dreiiuu/CPE027-soil-dsp/docs/handoff/Smart_Irrigation_DSP_Software_Handoff.md

# CONTEXT AND IMPLEMENTATION PROMPT FOR DSP / SOFTWARE DEVELOPMENT

I am building an **ESP32-S3 N16R8-based soil moisture monitoring and automatic irrigation prototype**. Please use the details in this handoff as the project baseline, and use the attached **`Smart_Irrigation_ESP32S3_Final.ino`** as the source of truth for firmware behavior and telemetry. Do not assume hardware or features have been proven unless explicitly marked as verified.

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

## 5. Firmware behavior (attached .ino v1)
- **Boot:** The relay is driven to its configured de-energized electrical state as soon as possible; automatic watering defaults to OFF. External LED is tested for 2 seconds at startup. The TFT is initialized and keeps its static title/labels. Automatic pump commands are blocked until an explicit code constant `PUMP_HARDWARE_VERIFIED` is changed to `true` after physical correction and supervised tests.
- **Sampling:** Every **1 second**, all three sensors are sampled. Each raw reading averages **12 ADC samples**, followed by an **exponential moving average (EMA) filter with alpha = 0.25**. ESP32 ADC is configured to 12-bit reads (0–4095) and high attenuation (`ADC_11db`). Raw and filtered ADC counts are exposed in telemetry.
- **Calibration:** Sending serial `D` saves a dry reference for every sensor; sending `W` saves a wet reference for every sensor. Values are stored in ESP32 Preferences/NVS and survive restarts. Require >=150 ADC count difference between dry and wet for each sensor. The calibration percentage is **relative to these two points**: `pct = clamp(100 * (filtered - dry) / (wet - dry), 0, 100)`. The formula works irrespective of the direction of raw changes. Missing or invalid calibration produces `null` percentages and the TFT displays CAL REQUIRED; this replaces old `AVG=-1` semantics in the machine-readable stream.
- **Mean moisture:** Equal-weight average of three calibrated moisture percentages. They are considered sensors for one shared watering area. Independent irrigation zones would need different pumps/valves and new logic.
- **Starting thresholds:** average below **50%** requests watering; average >= **70%** clears the request. Hysteresis prevents rapid relay switching. These are **adjustable prototype thresholds**, not validated volumetric water content; crop, soil and calibration must be studied. Irrigation extension literature recommends crop/soil-dependent management allowable depletion of plant-available water. That physical quantity is different from a two-point capacitive calibration percentage.
- **Watering sequence:** Automatic mode enabled manually by serial `A` only after valid calibration, healthy sensor reading and successful relay hardware verification. Pump turns on for a maximum **1,500 ms**, switches off, and waits at least **20,000 ms** for moisture redistribution. Up to **3 pulses** are permitted in a run; hitting the pulse limit latches `lockout=true`, disables automatic mode, and requires operator inspection/`X` to clear. The next `A` is required for re-enable.
- **LED:** Lights continuously while there is a calibrated low-moisture watering demand; blinks on obvious sensor faults (near ADC rails); `L` is a 2-second LED test.
- **Safety:** Sensor readings near ADC 0 or 4095 are classified as fault; relay commanded OFF and AUTO disabled. Not all faults are detectable. Pump/relay status is the **software command only**, not an independent flow measurement. Real dry-run / tank-empty detection is not implemented. This code is for supervised testing, not unattended deployment.
- **Display:** 320x240 landscape; fixed header and labels; only changing values are redrawn to avoid screen flashing. Shows S1/S2/S3 raw or relative %, average/diagnostics, pump command, mode and warning/pulse count.

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

## 7. Serial protocol for DSP / computer dashboard
- Transport: USB CDC/serial, **115200 baud**, device port COM7 in previous tests (port can change).
- Each **telemetry** record is a complete **JSON object on one line** (JSON Lines / NDJSON). Parse only lines beginning with `{` and with `"type":"telemetry"`; other messages begin `#EVENT` for human diagnostics.
- Fields and semantics:
  - `type`: `"telemetry"`
  - `v`: protocol version number (1)
  - `ms`: milliseconds of microcontroller uptime; NOT an absolute datetime
  - `raw`: integer array of 3 unfiltered 12-bit ADC averages
  - `filtered_raw`: integer array of 3 EMA-smoothed ADC counts
  - `moisture_pct`: array of 3 integers 0–100, or null for a sensor when calibration is missing or faults invalidate readings
  - `average_pct`: integer 0–100 or null when calibration/validity is missing
  - `calibrated`, `sensor_fault`, `water_needed`, `pump_commanded`, `led_on`, `auto_mode`, `lockout`, `hardware_verified`: booleans
  - `pulses`: integer number of irrigation pulses in the current cycle
- Example only, NOT a real measurement:
  `{"type":"telemetry","v":1,"ms":60123,"raw":[2580,3160,3197],"filtered_raw":[2582,3163,3196],"moisture_pct":[44,48,52],"average_pct":48,"calibrated":true,"sensor_fault":false,"water_needed":true,"pump_commanded":false,"led_on":true,"auto_mode":true,"lockout":false,"pulses":1,"hardware_verified":true}`
- USB Serial commands, single letters (send newline if needed): `D` dry calibration, `W` wet calibration, `A` automatic enable, `X` stop/reset software lockout, `L` LED test, `T` supervised pump pulse, `?` help. Do not let GUI buttons send high-risk commands accidentally; require user confirmation and physical safety checks.

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

## 9. Remaining physical checks / known limitations
- Confirm isolated ESP32 power is approximately 3.3V; external 5V supply approximately 5.0V DC. Earlier unusual values were not clearly resolved.
- Correct the reversed pump operation: COM->positive adapter, NO->pump positive, NC unused, pump negative->adapter negative. Verify relay signal polarity and 3.3V trigger support. The final .ino deliberately blocks running until this is confirmed.
- Confirm LED polarity, proper resistor value in series, and breadboard row placement; the LED had not lit in previous testing.
- Confirm the exact ILI9341 module voltage/backlight requirements and avoid overloading the ESP32's onboard 3.3V regulator.
- Check possible GPIO3 strapping restrictions in the final PCB.
- Select power adapter, fuse, relay-contact ratings, terminal wire gauges, and diode based on the pump's actual operating and startup current.
- No water-level sensor, flow sensor, cloud connection, Wi-Fi integration, multi-zone valves, validated field thresholds, or true unattended safety setup has yet been implemented.

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
