dreiiuu/CPE027-soil-dsp/(commit log)

2026-10-29 Wiring check: flag disconnected/shorted sensors in serial, TFT and dashboard; show pin map
    Sensor counts stuck under 200 (no signal) or over 4000 (at 3.3 V) for 3 s are
    flagged per sensor. /api/state now carries flt[] and the pin map so the
    dashboard shows which GPIO each reading comes from. Serial 'p' prints the pin
    map. The DSP path is unchanged. Host simulation covers the fault cases.
    Claude-Session: https://claude.ai/code/session_016L6sXfA1Dicfr34gWNwWB8
    [soil_dsp.ino]
2026-10-29 v1.0: connect the handoff firmware to a PC software UI over USB serial
    - firmware/smart_irrigation: the handoff's Smart_Irrigation_ESP32S3_Final.ino, unchanged
    (ILI9341, sensors on 1/2/3, LED 5, relay 6, JSONL telemetry v1, pump blocked until verified)
    - software/irrigation_ui: PC app (stdlib + pyserial). Serial auto-detect and reconnect, strict
    protocol v1 parsing, PC timestamps, missing-record and reboot detection, CSV/event logs, live
    dashboard (sensors, average, demand, pump command, LED, mode, pulses, faults, lockout),
    display-only DSP comparison and analysis, confirmed commands (localhost, same-origin),
    SYNTHETIC simulator that ports the firmware logic, log replay
    - software/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
    [__main__.py, analysis.py, protocol.py, server.py, smart_irrigation.ino]
2026-10-29 Firmware v2.0: automatic watering, calibration from raw values, bench test input
    Firmware (smart_irrigation.ino v2.0, written from the v2 handoff spec; the v2 .ino itself
    was not supplied):
    - AUTO starts by itself after power-on when calibrated, sensors good, hardware verified and
    not paused/locked out; 5 s settling after boot and after a new calibration
    - PAUSE and LOCKOUT stored in NVS; X pauses and clears lockout, A resumes, W/$CAL arms AUTO;
    a sensor fault pauses AUTO until A
    - lockout only after the third pulse and its soak time
    - manual T always runs its full 1.5 s (v1 cut it to ~0.5 s when uncalibrated or >= 70 %)
    - $CAL d1 d2 d3 w1 w2 w3: store references from raw values (same li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
2026-10-30 Firmware v2.1: median 3 + moving average 5 filter, DRY/WET status, per-sensor dashboard graphs
    - Firmware: per sensor, 3-point running median then 5-point moving average
    (replaces EMA 0.25), as in the DSP paper. Average of the three is rounded.
    DRY/WET status with hysteresis (DRY below start, WET from stop), shown on
    the TFT and sent as an optional "status" telemetry field.
    - dsp.h copied into the sketch folder; Makefile checks the copies match.
    - Simulator, protocol parser, CSV log and dashboard filters updated to match.
    - Dashboard: three raw-vs-smoothed graphs (one per sensor) with DRY/WET
    badges; sensor numbers, calibration/bench test and old charts folded.
    - Docs: INTEGRATION mi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
    [analysis.py, protocol.py, smart_irrigation.ino, sources.py, station.py]
2026-10-30 Firmware: put the median/moving-average filter in the sketch itself (no dsp.h needed)
    The Arduino IDE failed with 'dsp.h: No such file' when only the .ino was copied.
    [smart_irrigation.ino]
2026-10-30 VS Code tasks: build, flash and run the dashboard with arduino-cli
2026-11-06 Firmware v2.3: 10 Hz control, median 3 + MA 3, immediate stop at 70%, relay on GPIO5, LED on GPIO6
    - firmware/smart_irrigation: the team's v2.3 sketch (header pin comment corrected to match the code:
    relay 5, red LED 6); PUMP_HARDWARE_VERIFIED=true
    - Makefile app-test: build a locked copy (PUMP_HARDWARE_VERIFIED=false) for the "relay never on"
    scenario and a verified copy for the watering scenario, whatever the shipped flag is
    - tests: bench-test step expects one pulse within 4 s (soak is now 5 s)
    - PC app: parse and reproduce v2.3's relay_test_active / relay_output_commanded fields
    - README: v2.3 and the new pins; note that the paper's results come from v2.1 (commit 9b24d17)
    Co-Authore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
    [protocol.py, smart_irrigation.ino]
2026-11-06 Firmware v2.4: remove the TFT display; the PC dashboard is the system's display
    - firmware/smart_irrigation: TFT code, display cache and Adafruit GFX/ILI9341 includes removed;
    GPIO 8-12 no longer driven. Control, filter, LED, relay and telemetry unchanged from v2.3.
    - tests: host run no longer resets the removed display cache
    - README: v2.4, no TFT
    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
    [smart_irrigation.ino]
2026-11-06 Dashboard: Reset view button; labels say median 3 + MA 3
    - "Reset view" (Session card) clears the dashboard's history, warnings, events and counters
    after a confirmation. The board and the CSV log are not touched. POST /api/reset_view.
    - graph and table labels now match firmware v2.4 (moving average 3)
    - test for the reset (history, counters and events cleared, no false gap afterwards)
    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
    [server.py, station.py]
2026-11-06 Firmware v2.5: S2 not used; one-tap calibration that a disconnected S2 cannot block
    - SENSOR_USED = {S1, S3}: an unused sensor is ignored for faults, calibration checks and the
    average (its raw reading is still sent). Telemetry adds "sensors_used".
    - D/W: a repeated tap within 2 s is ignored; a refused calibration names the sensor at fault
    - dashboard: unused sensors shown as "not used" (table and graph), no warnings for them, $CAL
    fills their values; Calibrate DRY/WET lock for 3 s after one tap and say what to do next
    - tests: S2 at 0 does not fault or block calibration, double tap ignored, average of S1 and S3
    Claude-Session: htt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
2026-11-06 Firmware v2.6: S2 shows its own calibrated reading but never counts
    - sensorPercent: a sensor outside SENSOR_USED (S2) reports its own percentage when its own
    references are valid and its reading is sane; the average, fault check and pump decision
    still use S1 and S3 only
    - dashboard: S2 shown with its real values, labelled "shown only, not in average"
    - test: S2 at 20% with S1/S3 at 62% gives S2 = 20% and an average of 62%
    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
2026-11-06 Firmware v2.7: a faulty sensor is only a warning, the system keeps working
    - A deciding sensor that reads 0/4095 or has no valid calibration is skipped:
    its % is null, the average uses the remaining sensors, AUTO keeps running.
    No pause and no stop on a sensor fault any more.
    - Only when no deciding sensor is usable is the pump held off; it carries on
    by itself (no A needed) once one reads normally again.
    - D/W and $CAL store the good sensors and skip a bad one (it keeps its old
    references); rejected only when no deciding sensor is valid.
    - Telemetry adds "sensor_ok" (which sensors give a usable % right now).
    - Dashboard: the fault is a yellow warning naming the skipped sensor;
    "NO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
    [protocol.py, smart_irrigation.ino, sources.py, station.py]
2026-11-06 Thresholds 60/98 %, sensor graphs always show values
    - Firmware: START_WATERING_PCT 60 (DRY below 60 %), STOP_WATERING_PCT 98
    (WET from 98 %). Dashboard, simulator and CLI defaults match.
    - Dashboard per-sensor graphs: 0-100 % with the 60/98 lines when the sensor
    has a %; otherwise its raw and smoothed ADC counts, labelled, instead of
    an empty "calibrate first" box.
    - Host test scenarios use 100 % as "wet" (75 % is now between thresholds).
    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
2026-11-06 Firmware v2.8: built-in calibration, no D/W needed
    - DEFAULT_DRY_ADC {1504,1644,1943} / DEFAULT_WET_ADC {1096,624,1187}: the
    board's references from the 30 Oct 2026 session log. Any sensor without a
    valid stored calibration uses them at boot, so percentages and AUTO work
    straight after upload. D/W/$CAL still override them.
    - A pause (X) no longer survives a restart; the safety lockout still does.
    - Tests and dashboard text updated.
    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
    [smart_irrigation.ino, station.py]
2026-11-06 Back to firmware v2.4 to match the paper and presentation
    Reverts the v2.5-v2.8 behaviour changes (S2 not counted, fault as warning
    only, 60/98 % thresholds, built-in calibration, pause cleared at boot).
    Final build = v2.3 logic with the TFT removed and relay GPIO5 / LED GPIO6.
    Kept on the dashboard: Reset view, and raw ADC counts in a sensor's graph
    until it is calibrated.
    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
    [__main__.py, analysis.py, protocol.py, smart_irrigation.ino, sources.py, station.py]
